ramonqu7/LI-FI-Arduino/pypic/expimg/April_Fools_Day-128.png

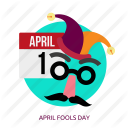
pypic/expimg/April_Fools_Day-128.png
