ramonqu7/LI-FI-Arduino/pypic/expimg/b96_15-128.png

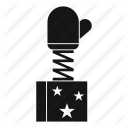
pypic/expimg/b96_15-128.png
