ramonqu7/LI-FI-Arduino/pypic/expimg/b96_16-256.png

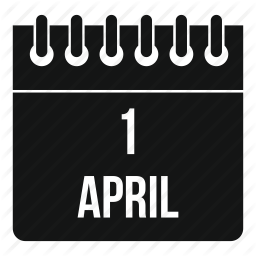
pypic/expimg/b96_16-256.png
