ramonqu7/LI-FI-Arduino/pypic/img/imageToSave.jpg

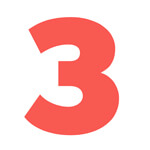
pypic/img/imageToSave.jpg
