ramonqu7/LI-FI-Arduino/transmitter/exp1.jpg

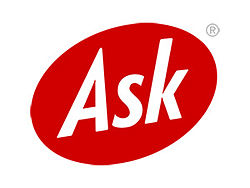
transmitter/exp1.jpg
